claudiusmarius/Platine-de-developpement-pour-ATtiny85-New-concept-DFTA91/README.md

# Platine-de-developpement-pour-ATtiny85-New-concept-DFTA91
J’ai voulu faire cette petite vidéo avec un guide afin que chacune ou chacun s’intéressant à l’ATtiny85, puisse réaliser cette carte de développement pour ce mini et très intéressant MCU. https://youtu.be/x3gs_hjUjcw
