claudiusmarius/Platine-de-developpement-pour-ATtiny85-New-concept-DFTA91/Capture d’écran 2023-05-28 190511.jpg

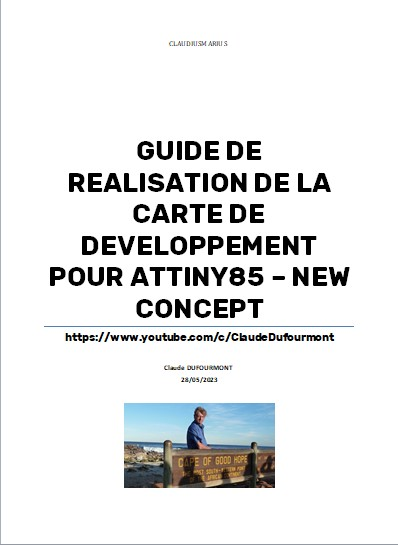
Capture d’écran 2023-05-28 190511.jpg
