claudiusmarius/Platine-de-developpement-pour-ATtiny85-New-concept-DFTA91/Schéma.pdf

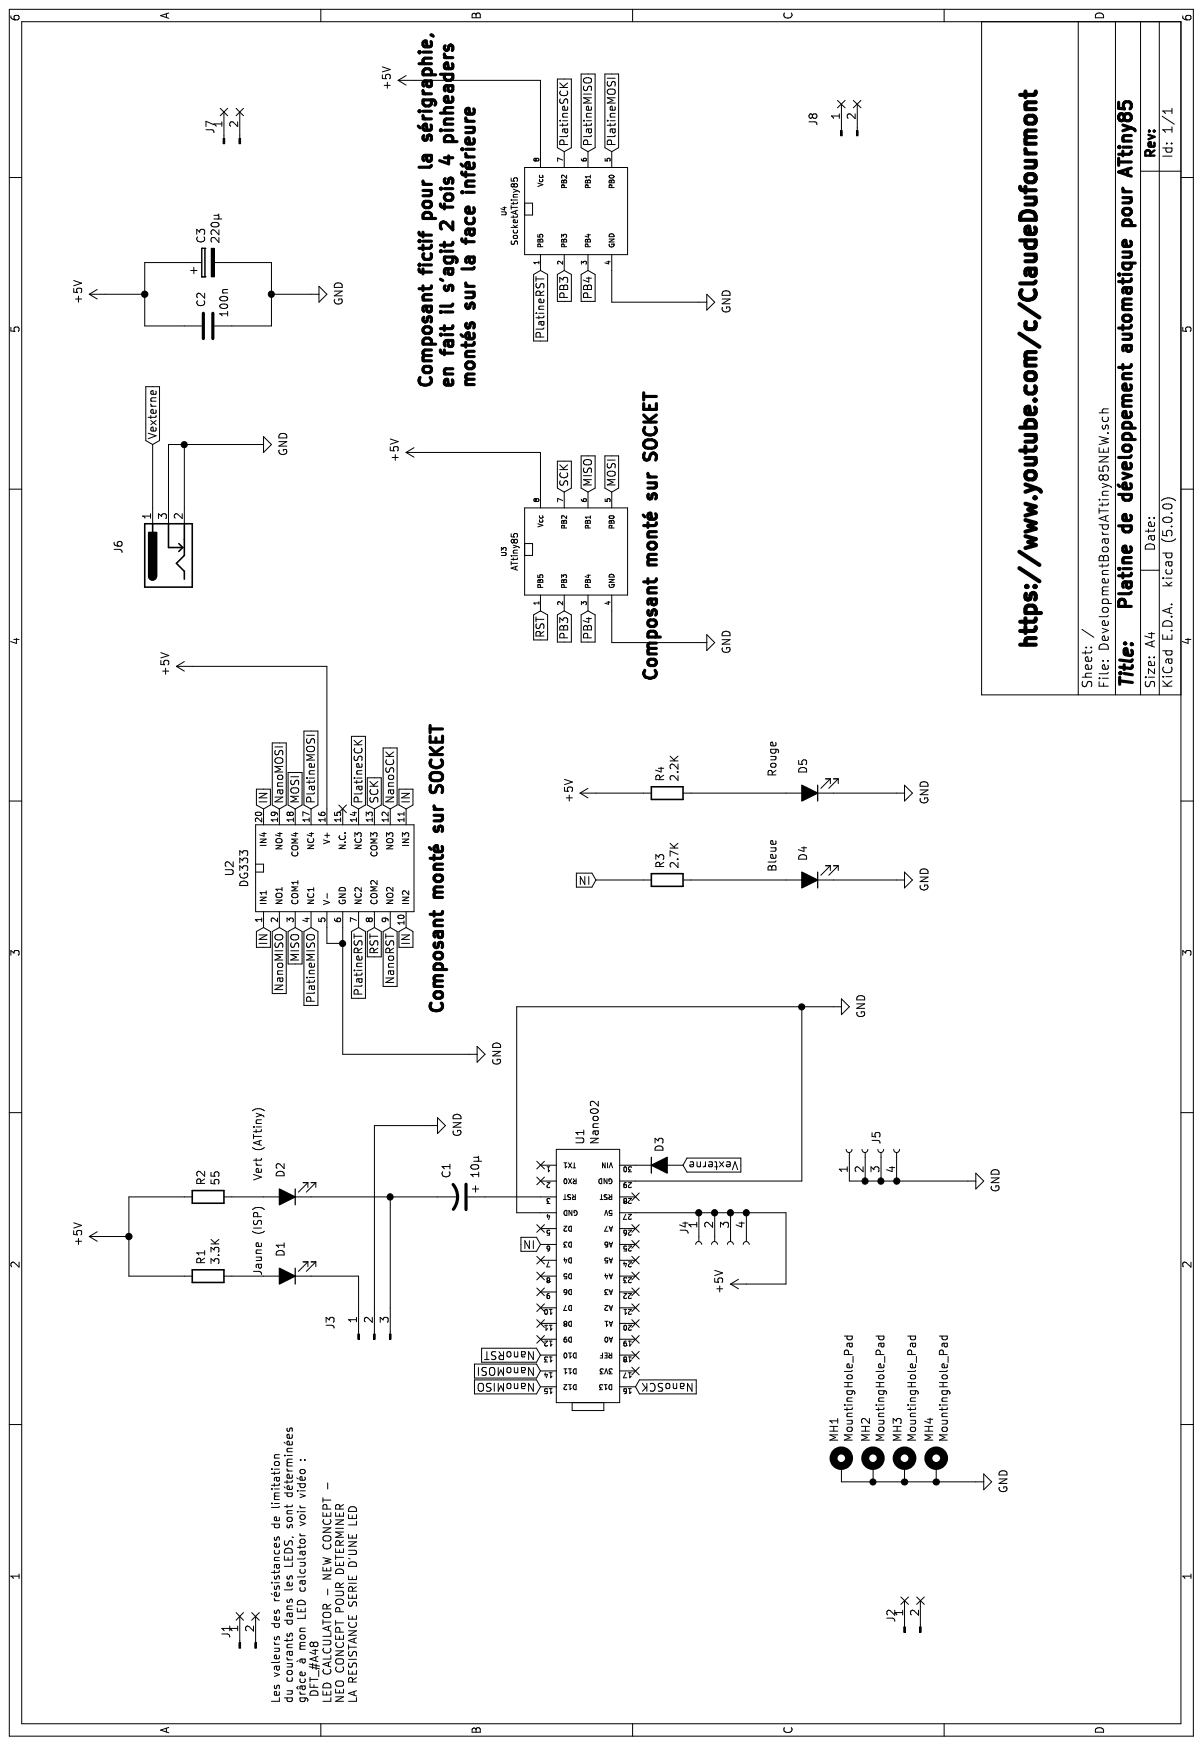
[picture p2: page 1]
